V0giK/sStromDingens/Hardware/Documents/CH32V003J4M6_PinOut.txt

CCH32V003J4M6
SOP-8

Pin 1 = PD6/A6/URX/T2CH3_/UTX_ = PA1/OSCI/A1/T1CH2/OPN0
Pin 2 = VSS
Pin 3 = PA2/OSCO/A0/T1CH2N/OPP0/AETR2_
Pin 4 = VDD
Pin 5 = PC1/SDA/NSS/T2CH4_/T2CH1ETR_/T1BKIN_/URX_
Pin 6 = PC2/SCL/URTS/T1BKIN = PC2/AETR_/T2CH2_/T1ETR_
Pin 7 = PC4/A2/T1CH4/MCO/T1CH1CH2N_
Pin 8 = PD4/A7/UCK/T2CH1ETR/OPO/T1CH4ETR_ = PD5/A5/UTX/T2CH4_/URX_ = PD1/SWIO/AETR2/T1CH3N/SCL_/URX_
