V0giK/sStromDingens/CHANGELOG.md

# Changelog - sStromDingens

Alle Änderungen dieses Projekts werden in diesem Dokument festgehalten.

Versionsschema: **X.Y.Z**
- **X**: Hardware-Version
- **Y**: Software-Hauptversion
- **Z**: Software-Bugfix (und FX-Unterversion)

---

## [3.0.1] - 2026/05/03

### Software v3.4.1 (Afterburner FX)
- **Änderung:** `PWM_MAX_DUTY` Standard jetzt 60% (ca. 500mA), konfigurierbar auf 80% (666mA) oder 100% (830mA)
- **Hinweis:** Alle Afterburner-Stufen erfordern modifizierte Hardware (2x300 mOhm parallel) bei >330mA
- **Update:** Dokumentation angepasst

### Software v3.0.1 (Basis-Firmware)
- **Neu:** Fuenf Compile-time LED-Varianten: `LED_1W`, `LED_3W`, `LED_500`, `LED_666`, `LED_830`
- **Änderung:** `LED_1W` nutzt Original-Hardware (330mA, 100%)
- **Hinweis:** `LED_3W`, `LED_500`, `LED_666`, `LED_830` erfordern modifizierte Hardware (2x300 mOhm parallel)
- **Update:** Dokumentation angepasst (READMEs, AGENTS.md)

---

## [3.0.0] - 2026/05/01

### Hardware v2.0 (unveraendert)

### Software v3.0.0 (Basis-Firmware)
- **Neu:** Hardware-PWM via TIM2_CH2 auf PC2 (2kHz, statt Software-PWM 100Hz)
- **Neu:** Compile-time LED-Typ-Auswahl: `#define LED_1W` (100% max) oder `#define LED_3W` (80% max)
- **Neu:** Hysterese im On/Off-Modus (EIN ab 1550us, AUS unter 1450us)
- **Entfernt:** `firmware_700mA/` aufgeloest in einheitliche `firmware/`
- **Fix:** AFIO-Takt korrekt aktiviert für TIM2-Remap
- **Fix:** `ch32v00x_exti.c` jetzt korrekt gelinkt

---

## [2.2.0] - 2026/03/25

### Hardware v2.0
- Layout ueberarbeitet und optimiert
- TVS-Dioden hinzugefuegt: SMF3.3CA (x2) für Eingangsschutz, SMAJ26CA für LED-Ausgang
- Ueberspannungsschutz SMAJ15A entfernt (D4, D5)
- Failsafe-Jumper von Pin 8 (PD4) auf Pin 1 (PD6) geändert

### Software v2.0.0
- Failsafe-Pin von PD4 (Pin 8) auf PD6 (Pin 1) geändert
- Hardware-Kompatibilitaet: Nur für Hardware v2.0

---

## [1.2.0] - 2026/03/17

### Hardware v1.0 (unverändert)

### Software v1.2.0
- Software-PWM via TIM2 Interrupt implementiert (100Hz, 100 Stufen)
- Linear-Modus implementiert (1ms→LED AUS, 2ms→LED AN)
- On/Off-Modus implementiert (<1.5ms→LED AUS, ≥1.5ms→LED AN)
- **Refactoring:** RC-Eingangsmessung auf EXTI-Interrupt umgestellt (statt Polling)
- **Bugfix:** Timer-Konfiguration für 24MHz SystemClock korrigiert
- **Bugfix:** signal_timeout Logik korrigiert
- AL8862 Dimming: pwm_duty=0→LED AUS, pwm_duty=100→LED AN

---

## [1.1.0] - 2026-03-10

### Hardware v1.0 (unverändert)

### Software v1.1.0
- Software-PWM via TIM2 implementiert (Hardware-PWM funktionierte nicht)
- Race-Condition behoben: Kopie von rc_pulse_us vor Löschen von rc_valid
- Author geändert zu V0giK, Copyright aktualisiert
- AGENTS.md und README.md aktualisiert

---

## [1.0.1] - 2026-02-23

### Hardware v1.0 (unverändert)

### Software v1.0.1
- Debug-Dateien (debug.h, debug.c) hinzugefügt
- printf-Unterstützung entfernt (16KB Flash-Limit)
- .clangd Konfiguration für Language Server
- PWM-Frequenz auf ~1000Hz korrigiert

---

## [1.0.0] - 2026-02-22

### Hardware v1.0
- Erste Version der Platine (v1.0)
- AL8862 Konstantstrom-LED-Treiber
- CH32V003J4M6 Mikrocontroller (SOP-8)
- Eingangsspannung: 5V-60V (LiPo 2S-3S)
- 1W LED ohne Vorwiderstand

### Software v1.0.0
- Erste Version der Firmware
- RC-Signal zu PWM Konverter
- Linearer Modus: 1ms → 0%, 2ms → 100%
- On/Off Modus: Schwelle bei 1.5ms
- Fail-Safe Konfiguration (per Jumper wählbar)
- RC-Timeout: 50ms

### Pinbelegung
| Pin | Funktion |
|-----|---|
| Pin 1 | SWIO (Programmierung) |
| Pin 2 | VSS (GND) |
| Pin 4 | VDD (3.3V) |
| PC1 (Pin 5) | Mode-Jumper |
| PC2 (Pin 6) | PWM-Ausgang → AL8862 CTRL |
| PC4 (Pin 7) | RC-Eingang |
| PD4 (Pin 8) | Fail-Safe-Jumper |
