V0giK/sStromDingens/Hardware/KiCad/sStromDingens/sStromDingens.kicad_pcb

## KiCad design Hardware/KiCad/sStromDingens/sStromDingens.kicad_pcb (2026-04-18)

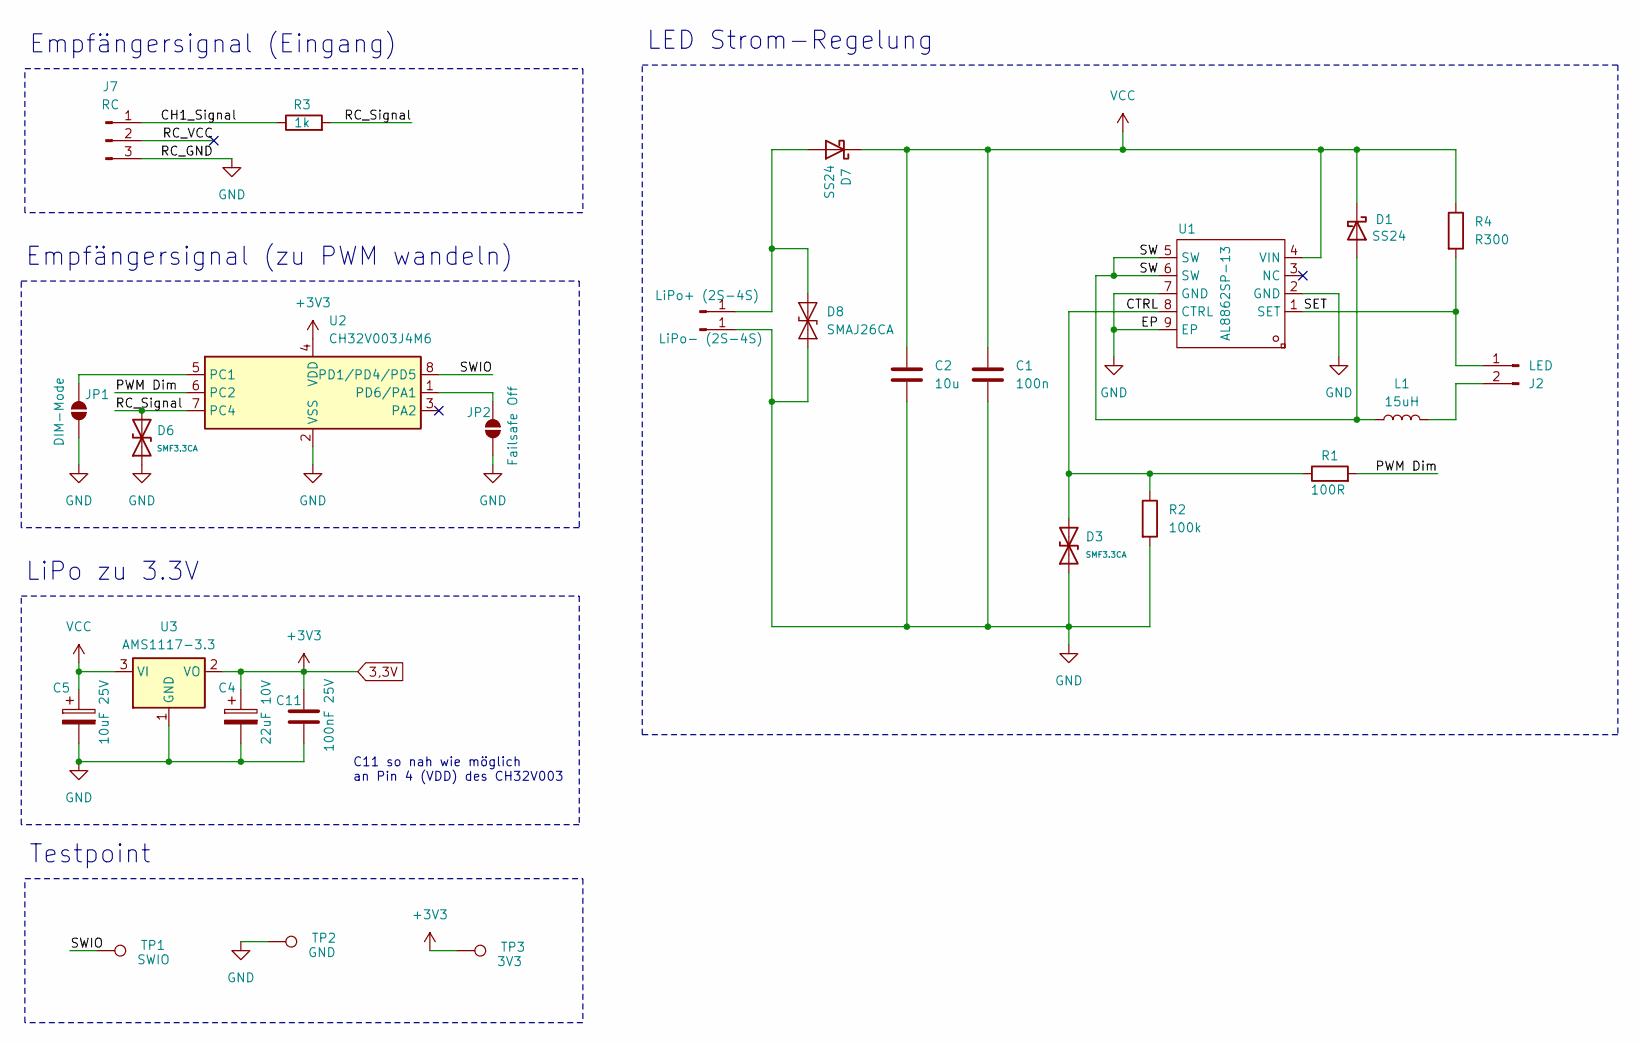
[picture p4: schematic sStromDingens.kicad_sch]

Parts:
C1: 100n; C_0805_2012Metric
C2: 10u; C_0805_2012Metric
C4: 22uF 10V; CASE-A_3216; MPN CA45-A-10V-22uF-K; LCSC SPN C129272
C5: 10uF 25V; CASE-B_3528; MPN CA45-B025K106T; LCSC SPN C119050
C11: 100nF 25V; C_0805_2012Metric; MPN GRM21BR71E104KA01L; LCSC SPN C86041
D1, D7: SS24; D_SMA
D3, D6: SMF3.3CA; SOD-123FL_L2.8-W1.8-LS3.7-BI; Breakdown Voltage 33.3V; Part SMF30CA; LCSC C2990493
D8: SMAJ26CA; D_SMB; MPN SMAJ26CA; LCSC SPN C148226
J1: LiPo+ (2S-4S); Conn_01x01_2.54_small
J2: LED; Conn_01x02_2.54
J3: LiPo- (2S-4S); Conn_01x01_2.54_small
J7: RC; Conn_01x03_2.54_small
JP1: DIM-Mode; SolderJumper-2_P1.3mm_Open_RoundedPad1.0x1.5mm
JP2: Failsafe Off; SolderJumper-2_P1.3mm_Open_RoundedPad1.0x1.5mm
L1: 15uH; IND-SMD_L7.1-W6.6; MPN SMMS0650-150M; LCSC SPN C149585
R1: 100R; R_0805_2012Metric
R2: 100k; R_0805_2012Metric
R3: 1k; R_0805_2012Metric
R4: R300; R_2512_6332Metric_Pad1.40x3.35mm_HandSolder
TP1: SWIO; TestPoint_Pad_D1.5mm
TP2: GND; TestPoint_Pad_D1.5mm
TP3: 3V3; TestPoint_Pad_D1.5mm
U1: AL8862SP-13; SO-8_L4.9-W3.9-P1.27-LS6.0-BL-EP; MPN AL8862SP-13; LCSC Part C526360
U2: CH32V003J4M6; JEITA_SOIC-8_3.9x4.9mm_P1.27mm; MPN CH32V003J4M6; LCSC SPN C5346354
U3: AMS1117-3.3; SOT-223-3_TabPin2; MPN AMS1117-3.3; LCSC SPN C6186

Connections:
3,3V: C4.1, C11.1, TP3.1, U2.4 (VDD), U3.2 (VO)
/CH1_Signal: J7.1, R3.1
/CTRL: D3.2 (A2), R1.1, R2.1, U1.8 (CTRL)
/PWM Dim: R1.2, U2.6 (PC2)
/RC_Signal: D6.2 (A2), R3.2, U2.7 (PC4)
/RC_VCC: J7.2
/SET: J2.1, R4.2, U1.1 (SET)
/SW: D1.2 (A), L1.1, U1.5 (SW), U1.6 (SW)
/SWIO: TP1.1, U2.8 (PD1/PD4/PD5)
GND: C1.2, C2.2, C4.2, C5.2, C11.2, D3.1 (A1), D6.1 (A1), D8.2 (A2), J3.1, J7.3, JP1.1 (A), JP2.1 (A), R2.2, TP2.1, U1.2 (GND), U1.7 (GND), U1.9 (EP), U2.2 (VSS), U3.1 (GND)
unnamed: D7.2 (A), D8.1 (A1), J1.1
unnamed: J2.2, L1.2
unnamed: JP1.2 (B), U2.5 (PC1)
unnamed: JP2.2 (B), U2.1 (PD6/PA1)
VCC: C1.1, C2.1, C5.1, D1.1 (K), D7.1 (K), R4.1, U1.4 (VIN), U3.3 (VI)

Notes on the sheet:
Empfängersignal (Eingang)
LED Strom-Regelung
C11 so nah wie möglich an Pin 4 (VDD) des CH32V003
Testpoint
LiPo zu 3.3V
Empfängersignal (zu PWM wandeln)

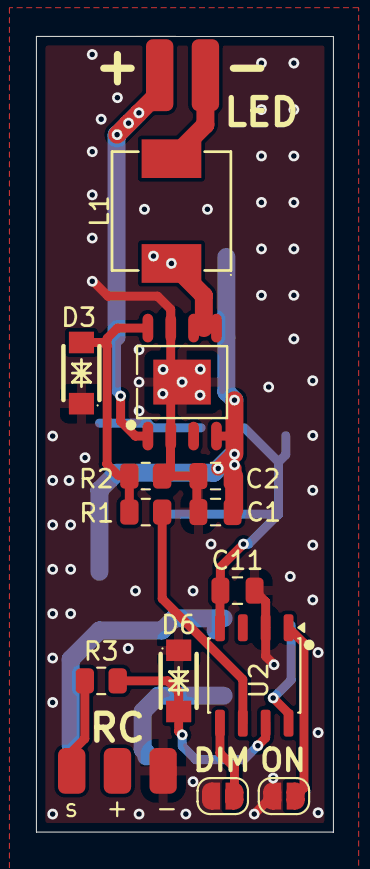
[picture p5: board sStromDingens.kicad_pcb from above]

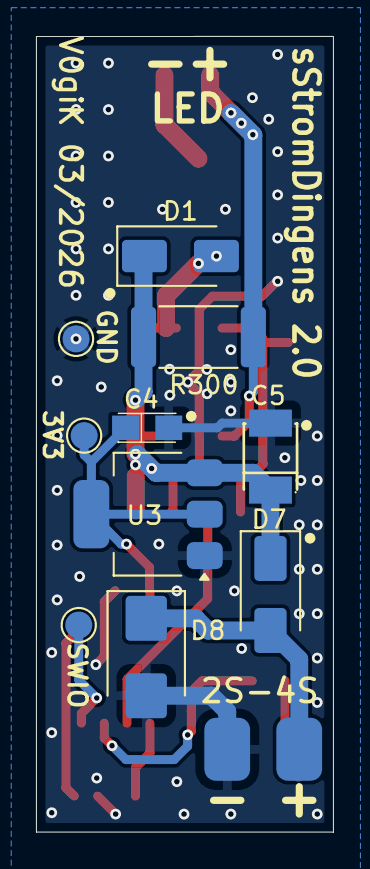
[picture p6: board sStromDingens.kicad_pcb from below]

Board: 2 copper layers, 16.5 x 44.2 mm, 27 parts (12 on the bottom side), 14 nets.
