V0giK/sStromDingens/Software/firmware_700mA_afterburner/User/debug.c

#include "debug.h"

static uint8_t  p_us = 0;
static uint16_t p_ms = 0;

void Delay_Init(void)
{
    p_us = SystemCoreClock / 8000000;
    p_ms = (uint16_t)p_us * 1000;
}

void Delay_Us(uint32_t n)
{
    uint32_t i;

    SysTick->SR &= ~(1 << 0);
    i = (uint32_t)n * p_us;

    SysTick->CMP = i;
    SysTick->CNT = 0;
    SysTick->CTLR |=(1 << 0);

    while((SysTick->SR & (1 << 0)) != (1 << 0));
    SysTick->CTLR &= ~(1 << 0);
}

void Delay_Ms(uint32_t n)
{
    uint32_t i;

    SysTick->SR &= ~(1 << 0);
    i = (uint32_t)n * p_ms;

    SysTick->CMP = i;
    SysTick->CNT = 0;
    SysTick->CTLR |=(1 << 0);

    while((SysTick->SR & (1 << 0)) != (1 << 0));
    SysTick->CTLR &= ~(1 << 0);
}

void USART_Printf_Init(uint32_t baudrate)
{
    (void)baudrate;
}

void SDI_Printf_Enable(void)
{
}
