V0giK/sStromDingens/(commit log)

2026-02-22 Initial commit: v1.0.0 - RC to PWM converter for 1W LED
    [bom.csv, designators.csv, positions.csv, sStromDingens.kicad_pcb, sStromDingens.kicad_sch]
2026-02-23 Add debug files and clangd config, remove printf to fit in 16KB flash
2026-02-23 Update firmware version to 1.0.1, add PWM frequency to README
2026-02-23 Bump version to 1.0.1, fix PWM frequency to 1000Hz
    [main.c]
2026-03-10 Implement Software-PWM, update to v1.1.0
    - Replace Hardware-PWM (TIM1) with Software-PWM (TIM2) for reliable output
    - Add TIM2 IRQ handler for PWM generation (~100Hz)
    - Fix race condition: copy rc_pulse_us before clearing rc_valid
    - Update author to V0giK, copyright to 2026
    - Update AGENTS.md: timer usage, build process, version
    - Update README.md: Software-PWM, pinout, RC timeout
    [ch32v00x_it.c, main.c]
2026-03-17 Implement v1.2.0: EXTI-based RC measurement, TIM2 PWM, 24MHz system clock
    - RC-Signal measurement via EXTI interrupt (rising + falling edge)
    - TIM2 software PWM at 100Hz (100 steps resolution)
    - Linear mode: 1ms→LED OFF, 2ms→LED ON (proportional dimming)
    - On/Off mode: <1.5ms→LED OFF, ≥1.5ms→LED ON
    - Fail-Safe: PD4=GND → LED ON on signal loss
    - Fix: Timer config for 24MHz system clock (TIM1 prescaler, TIM2 period)
    - Fix: signal_timeout logic corrected
    - Update documentation (README.md, AGENTS.md, CHANGELOG.md)
    - Remove outdated DEBUG_PROTOKOLL.md
    [ch32v00x_it.c, main.c]
2026-03-17 Add GitHub prompts and interactive BOM
    - Add firmware-code-review.prompt.md for AI-assisted code review
    - Add interactive BOM (ibom.html) for hardware assembly reference
2026-03-17 Update KiCad production files
2026-03-17 Refactor: Replace magic numbers with named constants
    - Add RC_PULSE_MIN_VALID (800µs) and RC_PULSE_MAX_VALID (2500µs) defines
    - Add PWM_STEPS (100) define for PWM resolution
    - Fix include style: use "ch32v00x_it.h" instead of <ch32v00x_it.h>
    - Update comments to reference new defines
    - Improves code maintainability and readability
    [ch32v00x_it.c, main.c]
2026-03-17 Fix: Replace German umlauts and special chars with ASCII equivalents
    - Replace umlauts (ae, oe, ue) for better encoding compatibility
    - Replace micro symbol (us) with ASCII 'us'
    - Replace arrow symbol (->) with ASCII '->'
    - Prevents encoding issues on different systems/editors
    [ch32v00x_it.c, main.c]
2026-03-17 Redesign README.md in kerosin style, change license to GPLv3
    - Add emojis to section headers for better readability
    - Restructure README with clear sections (Features, Components, Hardware, Software)
    - Change license from MIT to GPLv3 (ensures OpenSource stays OpenSource)
    - Add GPLv3 license headers to main.c and ch32v00x_it.c
    - Add author section with GitHub link
    - Add project slogan: 'Small chip, bright light – powered by RISC-V'
    [ch32v00x_it.c, main.c]
2026-03-25 Hardware v2.0: Add TVS protection, move Failsafe to Pin 1
    - Add SMF3.3CA TVS diodes for input protection (LiPo)
    - Add SMAJ26CA TVS diode for LED output protection
    - Remove SMAJ15A overvoltage protection
    - Move Failsafe jumper from Pin 8 (PD4) to Pin 1 (PD6)
    [bom.csv, designators.csv, positions.csv, sStromDingens.kicad_pcb, sStromDingens.kicad_sch]
2026-03-25 Firmware v2.0.0: Update Failsafe pin for Hardware v2.0
    - Change Failsafe pin from PD4 to PD6 (Pin 1)
    - Bump version to 2.0.0
    - Compatible only with Hardware v2.0
    [ch32v00x_it.c, main.c]
2026-03-25 Docs: Update documentation for v2.2.0
    - Update pin assignments in AGENTS.md and README.md
    - Add CHANGELOG entry for v2.2.0
    - Update component lists with new TVS diodes
    - Change license to GPLv3
2026-03-25 Revise input voltage range for LED driver
    Updated input voltage specification for the LED driver.
2026-03-25 Docs: Korrigiere Eingangsspannungsangabe (LiPo 2S-3S)
2026-03-25 Docs/Firmware: Korrigiere Fail-Safe Pin von PD4 auf PD6 (Hardware v2.0)
    [main.c]
2026-03-25 Add *.lck to .gitignore for KiCad lock files
2026-03-27 Docs: Update project title to emphasize LED lighting purpose
2026-03-27 Docs: Add English README_EN.md with language switcher
2026-03-27 Docs: Update voltage specs - 2S-3S recommended, 6S possible outside AMS1117 spec
2026-03-27 Docs: Update AGENTS.md - fix Fail-Safe pin (PD4→PD6), update project structure
2026-03-27 Docs: Update jumper labels to match PCB silkscreen (DIM, ON)
2026-04-12 Hardware: Set STEP export path in KiCad project
2026-04-18 Docs/Hardware: LiPo-Spec von 6S auf 4S korrigiert (AMS1117 max. 15V)
    [sStromDingens.kicad_pcb, sStromDingens.kicad_sch]
2026-04-18 Fix: Verbleibende 6S/26V-Referenzen auf 4S/16.8V korrigiert
    [bom.csv, sStromDingens.kicad_pcb]
2026-04-28 Cleanup: KiCad .history/ zu .gitignore hinzugefügt
2026-04-28 Hardware: KiCad-Projektdateien auf neue Version aktualisiert
2026-04-28 Software: 700mA Firmware-Variante hinzugefügt
2026-05-01 Bump to v3.4.0: Hardware-PWM, Afterburner FX, docs cleanup
    Firmware:
    - Basis-Firmware v3.0.0: Software-PWM -> TIM2 Hardware-PWM @ 2kHz
    - Basis-Firmware: compile-time LED-Auswahl (LED_1W / LED_3W)
    - Basis-Firmware: Hysterese im On/Off-Modus (1450/1550us)
    - Afterburner v3.4.0: Neue State-Machine mit FX-Suite
    (Spool-Up, Ramp-Down, Cool-Down, Burst, Flame-Out, Flicker, Heat-Shimmer)
    - Afterburner: Selftest-Initialisierung korrigiert
    - Afterburner: TIM2-IRQ explizit deaktiviert (Residual-Sicherheit)
    Projektstruktur:
    - Veraltetes firmware_700mA/ entfernt
    - Neuer Ordner firmware_700mA_afterburner/
    Dokumentation:
    - CHANGELOG.md: v3.0.0 Eintrag hinzugefuegt
    - AGENTS.md: Duplikate entfernt, TIM2-I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
2026-05-03 Bump to v3.0.1/v3.4.1: Expand LED variants (330-830mA), PWM_MAX_DUTY config, version sync
2026-05-03 Set default LED to LED_1W (Original-Hardware, 330mA)
