V0giK/sStromDingens/(notices)

Notices in the files:
Software/firmware_700mA_afterburner/User/main.c:
sStromDingens is free software: you can redistribute it and/or modify
it under the terms of the GNU General Public License as published by
the Free Software Foundation, either version 3 of the License, or
(at your option) any later version.
README.md:
License: GPLv3
